veitforabetterworld/pegel-mesh/hardware/pegel-sender/verify/report/sweeps.md

# Schwellen und Verläufe (SPICE)

| Größe | Wert |
|---|---|
| Laden frei beim Erwärmen ab [°C] | 3.09 |
| Ladesperre beim Abkühlen ab [°C] | 0.978 |
| Heizung aus beim Erwärmen ab [°C] | 5.06 |
| Heizung an beim Abkühlen ab [°C] | 3.6 |
| Netzteil mit Steckbrücke: Laden ab [V] | 10.4 |
| Netzteil mit Steckbrücke: Laden bis [V] | 10.2 |
| Netzteil mit Steckbrücke: Ladestrom max. [A] | 2.36 |
| Netzteil ohne Steckbrücke: Laden ab [V] | — (keine Schaltung) |
| Netzteil ohne Steckbrücke: Laden bis [V] | — (keine Schaltung) |
| Netzteil ohne Steckbrücke: Ladestrom max. [A] | 0.0316 |
| Sonde 30 mA, Zelle 3.3 V: V12_PROBE Endwert [V] | 12.4 |
| Sonde 30 mA, Zelle 3.3 V: Anstieg auf 90 % [ms] | 1.43 |
| Sonde 30 mA, Zelle 3.3 V: Spitzenstrom Q5 [A] | 0.0301 |
| Sonde 30 mA, Zelle 3.3 V: Ugs Q5 min [V] | -6.22 |
| Sonde 30 mA, Zelle 2.9 V: V12_PROBE Endwert [V] | 12.4 |
| Sonde 30 mA, Zelle 2.9 V: Anstieg auf 90 % [ms] | 1.81 |
| Sonde 30 mA, Zelle 2.9 V: Spitzenstrom Q5 [A] | 0.0301 |
| Sonde 30 mA, Zelle 2.9 V: Ugs Q5 min [V] | -6.22 |

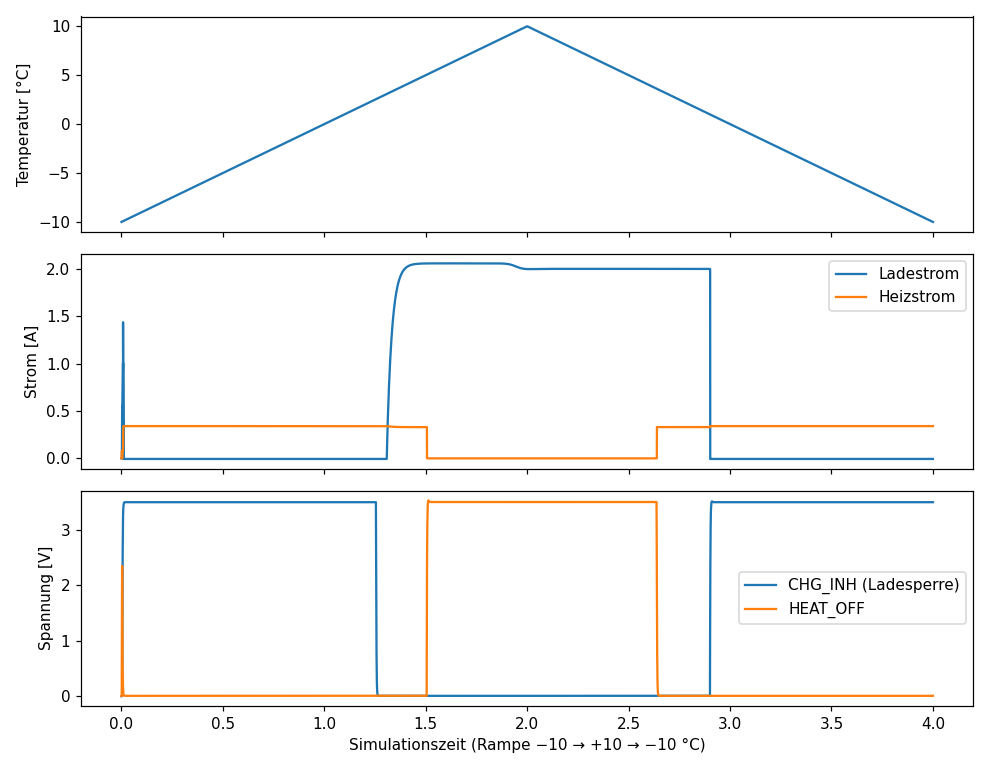
[picture p4: hardware/pegel-sender/verify/report/temperatur.png]
Temperatur


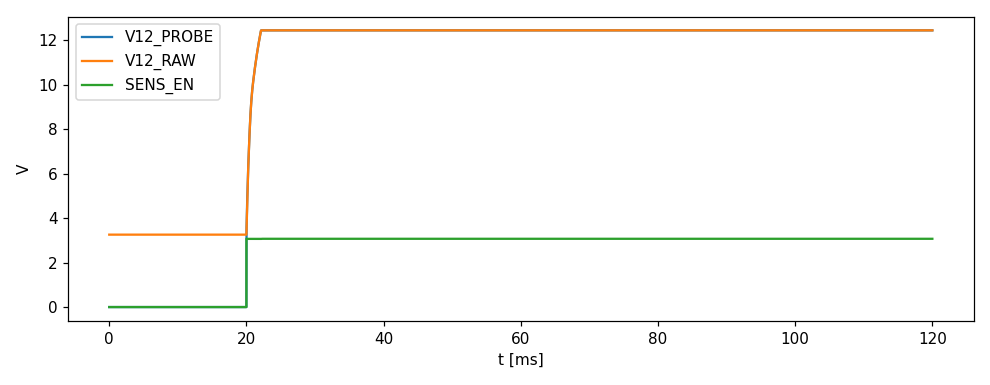
[picture p5: hardware/pegel-sender/verify/report/sonde_ein.png]
Sonde
