veitforabetterworld/pegel-mesh/hardware/pegel-sender/preview/pegel-sender-bottom.png

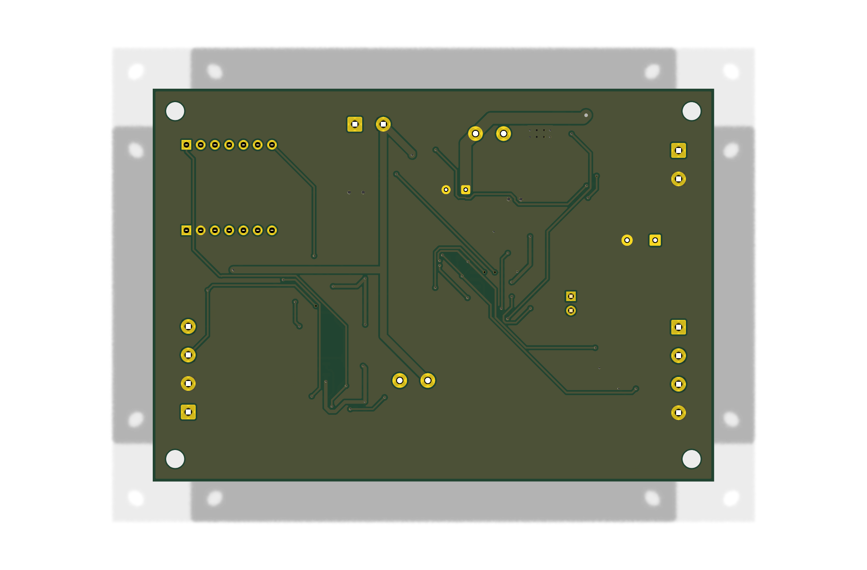
hardware/pegel-sender/preview/pegel-sender-bottom.png
