veitforabetterworld/pegel-mesh/hardware/pegel-sender/preview/pegel-sender-schematic-blocks.png

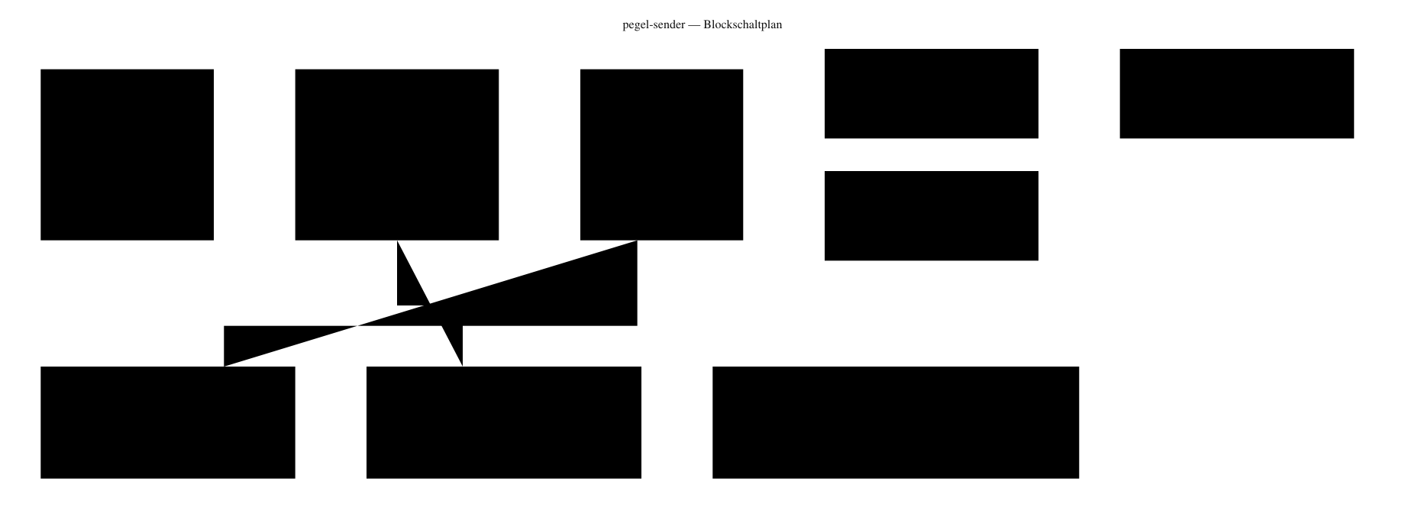
hardware/pegel-sender/preview/pegel-sender-schematic-blocks.png
