veitforabetterworld/pegel-mesh/hardware/pegel-sender/preview/schematic-12v.png

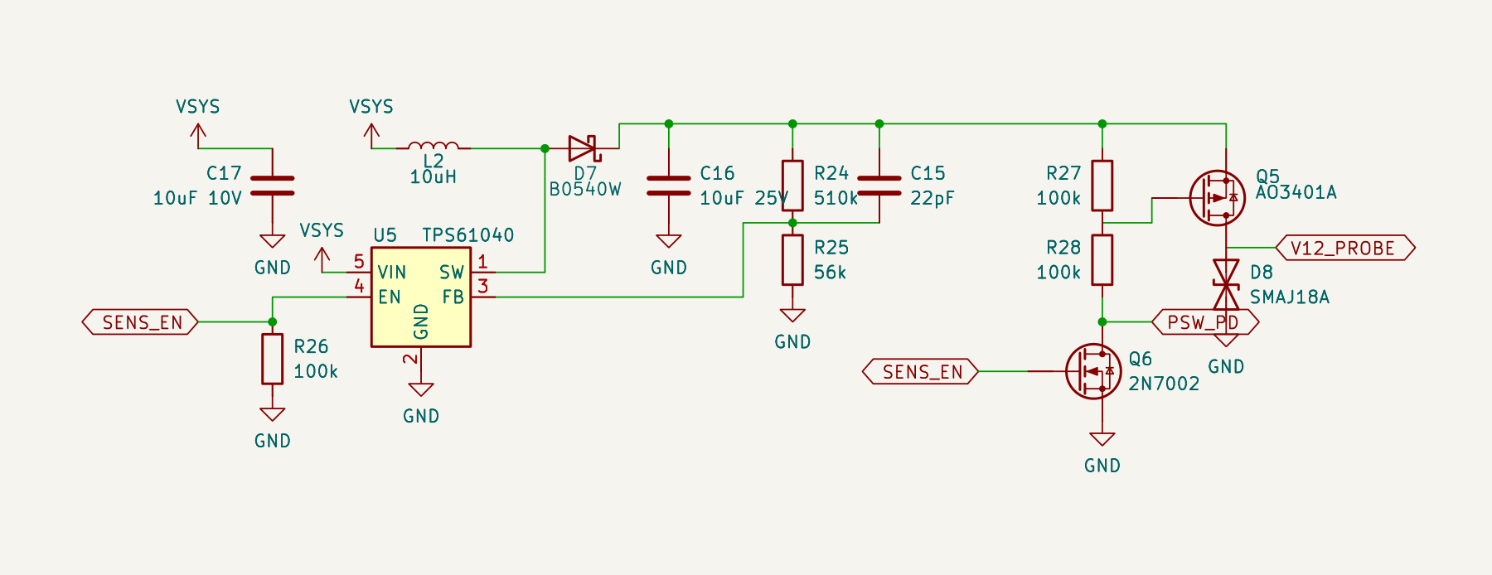
hardware/pegel-sender/preview/schematic-12v.png
