veitforabetterworld/pegel-mesh/hardware/pegel-sender/preview/schematic-battery.png

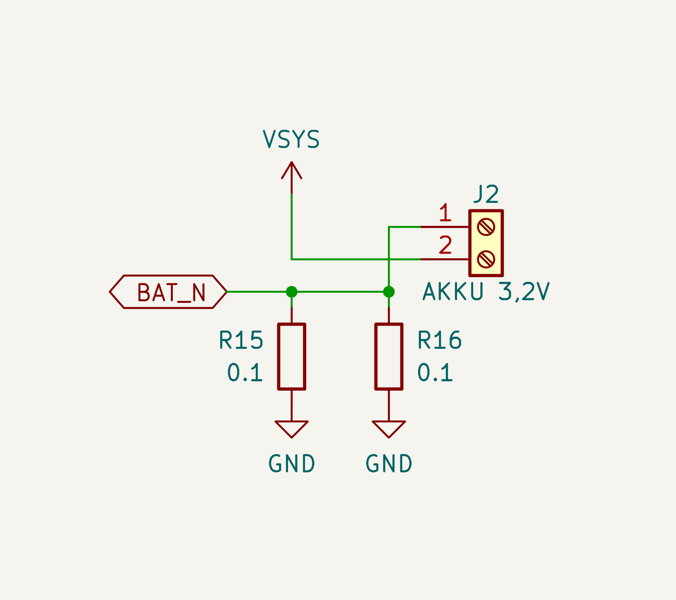
hardware/pegel-sender/preview/schematic-battery.png
