veitforabetterworld/pegel-mesh/hardware/pegel-sender/preview/schematic-charger.png

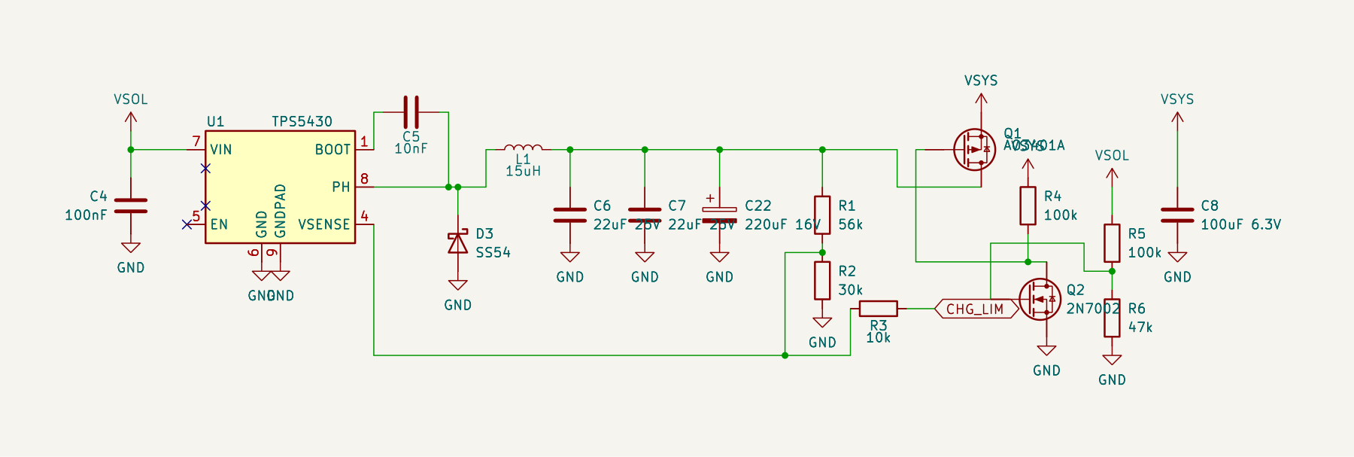
hardware/pegel-sender/preview/schematic-charger.png
