veitforabetterworld/pegel-mesh/hardware/pegel-sender/preview/schematic-frost.png

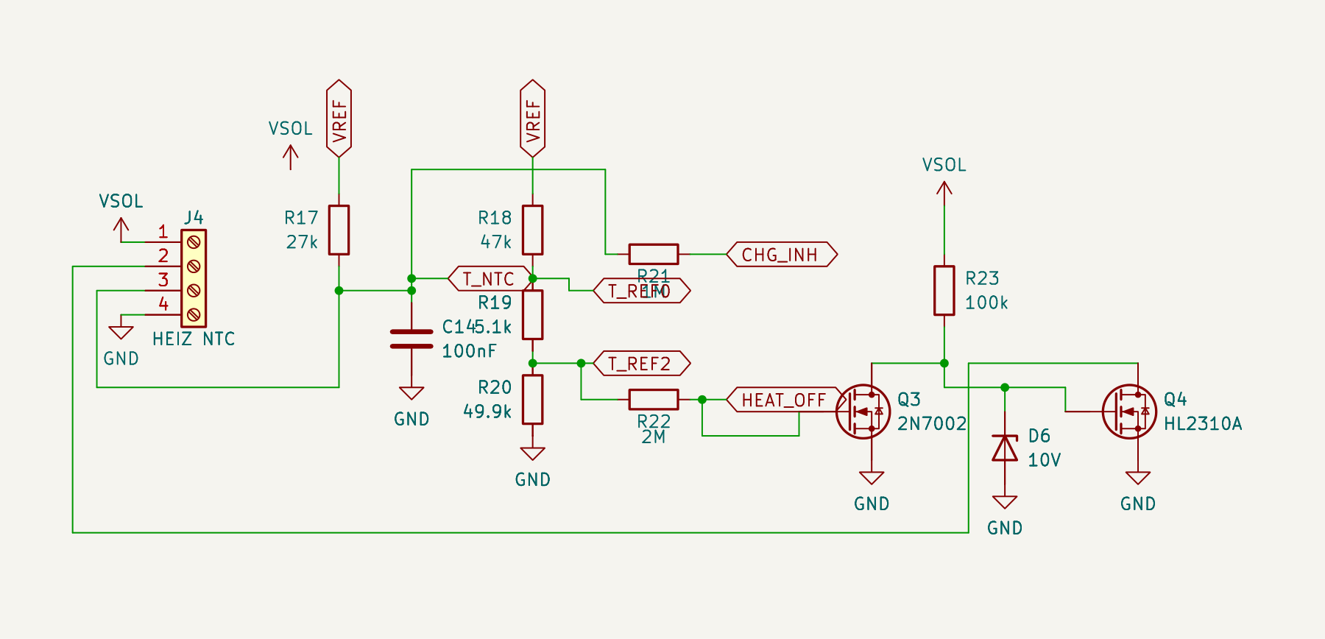
hardware/pegel-sender/preview/schematic-frost.png
