veitforabetterworld/pegel-mesh/hardware/pegel-sender/preview/schematic-mppt.png

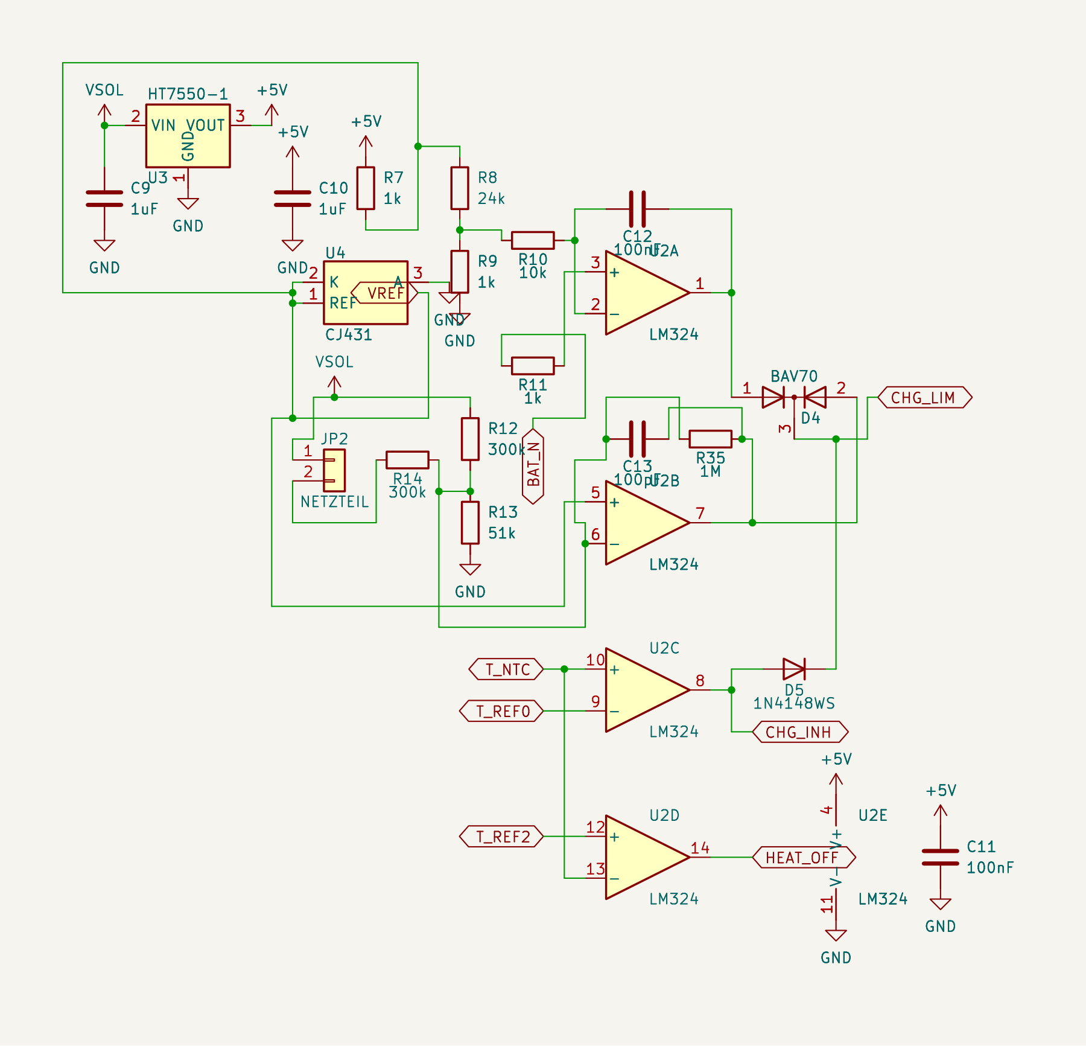
hardware/pegel-sender/preview/schematic-mppt.png
