veitforabetterworld/pegel-mesh/hardware/pegel-sender/preview/schematic-rs485.png

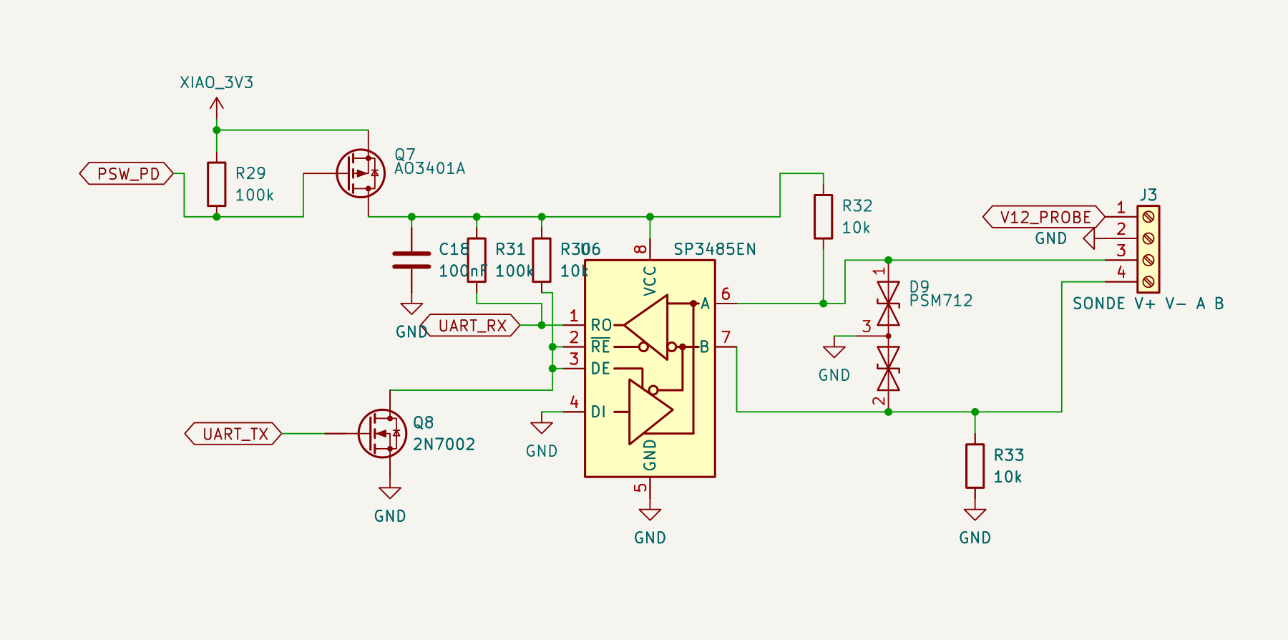
hardware/pegel-sender/preview/schematic-rs485.png
