veitforabetterworld/pegel-mesh/hardware/pegel-sender/preview/schematic-solar.png

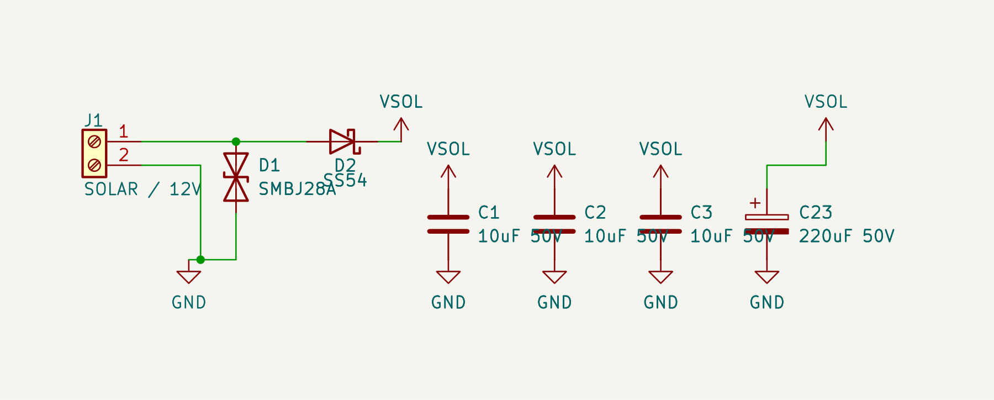
hardware/pegel-sender/preview/schematic-solar.png
