veitforabetterworld/pegel-mesh/hardware/pegel-sender/preview/schematic-xiao.png

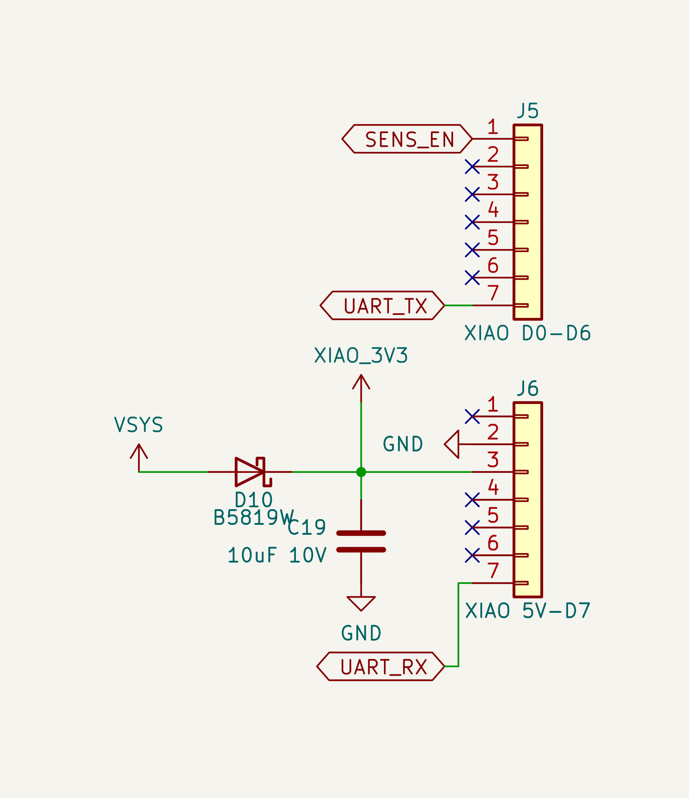
hardware/pegel-sender/preview/schematic-xiao.png
