veitforabetterworld/pegel-mesh/hardware/pegel-sender/fab/pegel-sender-bom.csv

Comment | Designator | Footprint | LCSC Part #
SMBJ28A | D1 | D_SMB | C19077582
SS54 | D2,D3 | D_SMA | C22452
10uF 50V | C1,C2,C3 | C_1206_3216Metric | C13585
TPS5430 | U1 | TI_SO-PowerPAD-8_ThermalVias | C9864
100nF | C4,C11,C12,C14,C18 | C_0603_1608Metric | C14663
10nF | C5 | C_0603_1608Metric | C57112
22uF 25V | C6,C7 | C_0805_2012Metric | C45783
56k | R1,R25 | R_0603_1608Metric | C23206
30k | R2 | R_0603_1608Metric | C22984
10k | R3,R10,R30,R32,R33 | R_0603_1608Metric | C25804
AO3401A | Q1,Q5,Q7 | SOT-23 | C15127
100k | R4,R5,R23,R26,R27,R28,R29,R31 | R_0603_1608Metric | C25803
2N7002 | Q2,Q3,Q6,Q8 | SOT-23 | C8545
47k | R6,R18 | R_0603_1608Metric | C25819
100uF 6.3V | C8 | C_1206_3216Metric | C15008
HT7550-1 | U3 | SOT-89-3 | C16106
1uF | C9,C10 | C_0603_1608Metric | C15849
LM324 | U2 | SOIC-14_3.9x8.7mm_P1.27mm | C71035
CJ431 | U4 | SOT-23 | C3113
1k | R7,R9,R11 | R_0603_1608Metric | C21190
24k | R8 | R_0603_1608Metric | C23352
300k | R12,R14 | R_0603_1608Metric | C23024
51k | R13 | R_0603_1608Metric | C23196
1M | R35,R21 | R_0603_1608Metric | C22935
100pF | C13 | C_0603_1608Metric | C14858
BAV70 | D4 | SOT-23 | C68978
1N4148WS | D5 | D_SOD-323 | C2128
0.1 | R15,R16 | R_1206_3216Metric | C25334
27k | R17 | R_0603_1608Metric | C22967
5.1k | R19 | R_0603_1608Metric | C23186
49.9k | R20 | R_0603_1608Metric | C23184
2M | R22 | R_0603_1608Metric | C22976
10V | D6 | D_SOD-123 | C19077408
HL2310A | Q4 | SOT-23 | C7420347
TPS61040 | U5 | SOT-23-5 | C7722
B0540W | D7 | D_SOD-123 | C7420325
510k | R24 | R_0603_1608Metric | C23192
22pF | C15 | C_0603_1608Metric | C1653
10uF 25V | C16 | C_0805_2012Metric | C15850
10uF 10V | C17,C19 | C_0603_1608Metric | C19702
SMAJ18A | D8 | D_SMA | C19077538
SP3485EN | U6 | SOIC-8_3.9x4.9mm_P1.27mm | C8963
PSM712 | D9 | SOT-23 | C32677
B5819W | D10 | D_SOD-123 | C64885
