veitforabetterworld/pegel-mesh/hardware/pegel-sender/pegel-sender.kicad_pcb

## KiCad design hardware/pegel-sender/pegel-sender.kicad_pcb (2026-10-31)

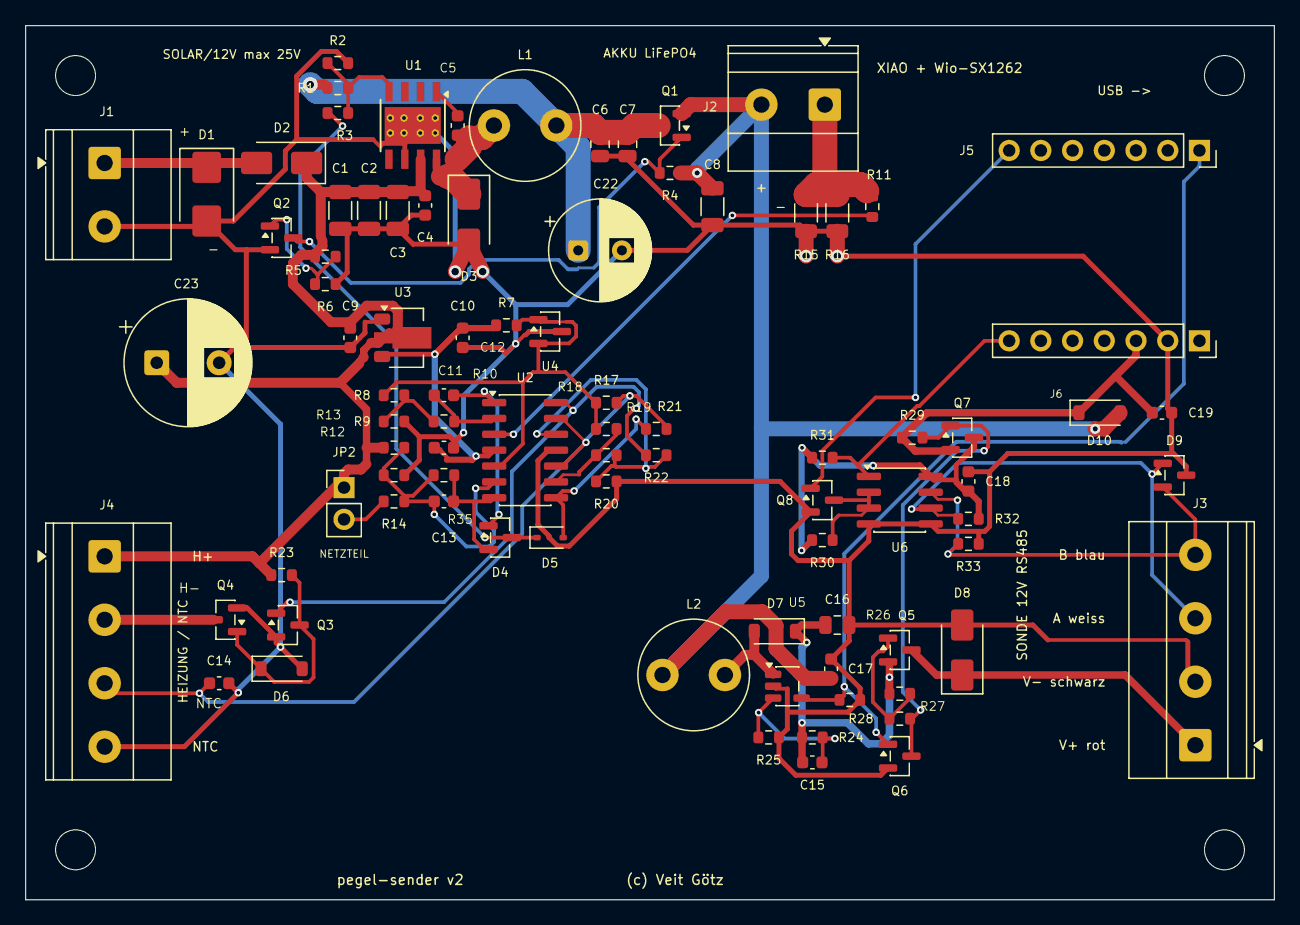
[picture p16: board pegel-sender.kicad_pcb from above]

Board: 2 copper layers, 100.0 x 70.0 mm, 92 parts (0 on the bottom side), 42 nets.

Parts:
C1, C2, C3: 10uF 50V; C_1206_3216Metric
C4, C11, C12, C14, C18: 100nF; C_0603_1608Metric
C5: 10nF; C_0603_1608Metric
C6, C7: 22uF 25V; C_0805_2012Metric
C8: 100uF 6.3V; C_1206_3216Metric
C9, C10: 1uF; C_0603_1608Metric
C13: 100pF; C_0603_1608Metric
C15: 22pF; C_0603_1608Metric
C16: 10uF 25V; C_0805_2012Metric
C17, C19: 10uF 10V; C_0603_1608Metric
C22: 220uF 16V; CP_Radial_D8.0mm_P3.50mm
C23: 220uF 50V; CP_Radial_D10.0mm_P5.00mm
D1: SMBJ28A; D_SMB
D2, D3: SS54; D_SMA
D4: BAV70; SOT-23
D5: 1N4148WS; D_SOD-323
D6: 10V; D_SOD-123
D7: B0540W; D_SOD-123
D8: SMAJ18A; D_SMA
D9: PSM712; SOT-23
D10: B5819W; D_SOD-123
H1, H2, H3, H4: M3; MountingHole_3.2mm_M3
J1: SOLAR / 12V; TerminalBlock_Phoenix_MKDS-1,5-2-5.08_1x02_P5.08mm_Horizont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
J2: AKKU 3,2V; TerminalBlock_Phoenix_MKDS-1,5-2-5.08_1x02_P5.08mm_Horizont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
J3: SONDE V+ V- A B; TerminalBlock_Phoenix_MKDS-1,5-4-5.08_1x04_P5.08mm_Horizont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
J4: HEIZ NTC; TerminalBlock_Phoenix_MKDS-1,5-4-5.08_1x04_P5.08mm_Horizont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
J5: XIAO D0-D6; PinSocket_1x07_P2.54mm_Vertical
J6: XIAO 5V-D7; PinSocket_1x07_P2.54mm_Vertical
JP2: NETZTEIL; PinHeader_1x02_P2.54mm_Vertical
L1: 15uH; L_Radial_D8.7mm_P5.00mm_Fastron_07HCP
L2: 10uH; L_Radial_D8.7mm_P5.00mm_Fastron_07HCP
Q1, Q5, Q7: AO3401A; SOT-23
Q2, Q3, Q6, Q8: 2N7002; SOT-23
Q4: HL2310A; SOT-23
R1, R25: 56k; R_0603_1608Metric
R2: 30k; R_0603_1608Metric
R3, R10, R30, R32, R33: 10k; R_0603_1608Metric
R4, R5, R23, R26, R27, R28, R29, R31: 100k; R_0603_1608Metric
R6, R18: 47k; R_0603_1608Metric
R7, R9, R11: 1k; R_0603_1608Metric
R8: 24k; R_0603_1608Metric
R12, R14: 300k; R_0603_1608Metric
R13: 51k; R_0603_1608Metric
R15, R16: 0.1; R_1206_3216Metric
R17: 27k; R_0603_1608Metric
R19: 5.1k; R_0603_1608Metric
R20: 49.9k; R_0603_1608Metric
R21, R35: 1M; R_0603_1608Metric
R22: 2M; R_0603_1608Metric
R24: 510k; R_0603_1608Metric
U1: TPS5430; TI_SO-PowerPAD-8_ThermalVias
U2: LM324; SOIC-14_3.9x8.7mm_P1.27mm
U3: HT7550-1; SOT-89-3
U4: CJ431; SOT-23
U5: TPS61040; SOT-23-5
U6: SP3485EN; SOIC-8_3.9x4.9mm_P1.27mm

Connections:
+5V: C10.1, C11.1, R7.1, U2.4, U3.3
BAT_N: J2.1, R11.1, R15.1, R16.1
BST_FB: C15.2, R24.2, R25.1, U5.3
BST_SW: D7.2, L2.2, U5.1
CC_INT: C12.1, R10.2, U2.2
CC_OUT: C12.2, D4.1, U2.1
CC_SENSE: R11.2, U2.3
CC_SET: R8.2, R9.1, R10.1
CHG_BOOT: C5.1, U1.1
CHG_FB: R1.2, R2.1, R3.2, U1.4
CHG_INH: D5.2, R21.1, U2.8
CHG_LIM: D4.3, D5.1, R3.1
CHG_OUT: C6.1, C7.1, C22.1, L1.2, Q1.3, R1.1
CHG_PG: Q1.1, Q2.3, R4.1
CHG_PGD: Q2.1, R5.2, R6.1
CHG_SW: C5.2, D3.1, L1.1, U1.8
GND: C1.2, C2.2, C3.2, C4.2, C6.2, C7.2, C8.2, C9.2, C10.2, C11.2, C14.2, C16.2, C17.2, C18.2, C19.2, C22.2, C23.2, D1.2, D3.2, D6.2, D8.2, D9.3, J1.2, J3.2, J4.4, J6.2, Q2.2, Q3.2, Q4.2, Q6.2, Q8.2, R2.2, R6.2, R9.2, R13.2, R15.2, R16.2, R20.2, R25.2, R26.2, R33.2, U1.6, U1.9, U2.11, U3.1, U4.3, U5.2, U6.4, U6.5
HEAT_G: D6.1, Q3.3, Q4.1, R23.2
HEAT_N: J4.2, Q4.3
HEAT_OFF: Q3.1, R22.1, U2.14
IN_RAW: D1.1, D2.2, J1.1
PSW_G: Q5.1, R27.2, R28.1
PSW_PD: Q6.3, Q7.1, R28.2, R29.2
RS485_A: D9.1, J3.3, R32.1, U6.6
RS485_B: D9.2, J3.4, R33.1, U6.7
RS_DE: Q8.3, R30.2, U6.2, U6.3
RS_VCC: C18.1, Q7.3, R30.1, R31.1, R32.2, U6.8
SENS_EN: J5.1, Q6.1, R26.1, U5.4
T_NTC: C14.1, J4.3, R17.2, R21.2, U2.10, U2.13
T_REF0: R18.2, R19.1, U2.9
T_REF2: R19.2, R20.1, R22.2, U2.12
UART_RX: J6.7, R31.2, U6.1
UART_TX: J5.7, Q8.1
V12_PROBE: D8.1, J3.1, Q5.3
V12_RAW: C15.1, C16.1, D7.1, Q5.2, R24.1, R27.1
VIN_DIV: C13.1, R12.2, R13.1, R14.2, R35.1, U2.6
VIN_J: JP2.2, R14.1
VIN_OUT: C13.2, D4.2, R35.2, U2.7
VREF: R7.2, R8.1, R17.1, R18.1, U2.5, U4.1, U4.2
VSOL: C1.1, C2.1, C3.1, C4.1, C9.1, C23.1, D2.1, J4.1, JP2.1, R5.1, R12.1, R23.1, U1.7, U3.2
VSYS: C8.1, C17.1, D10.2, J2.2, L2.1, Q1.2, R4.2, U5.5
XIAO_3V3: C19.1, D10.1, J6.3, Q7.2, R29.1
