veitforabetterworld/pegel-mesh/(commit log)

2026-10-29 feat: Pegel-Sender und -Empfänger auf MeshCore mit 13-Byte-HMAC-Paket
2026-10-29 fix(sender): Log blockiert den Sendetakt nicht mehr; Statuszeilen
    [main.cpp]
2026-10-29 feat(sender): Pegelsonde über RS485/Modbus RTU (D6 TX, D7 RX, D0 DE/RE)
    Liest wie water-level-sensor.ino Register 4 (Funktion 3, Adresse 0x01,
    9600 8N1) in cm; ohne gültigen Wert wird nichts gesendet. PEGEL_SENSOR=0
    schaltet auf Dummywerte zurück.
2026-10-29 feat: Fehlercodes der Pegelsonde über Funk und API (status)
    Sender: Lesefehler gehen als level_mm = 0xFF00 + Code statt eines Messwerts
    raus (1 keine Antwort, 2 außerhalb des Messbereichs). Empfänger: schickt sie
    als status an POST /v1/stations/{id}/observations.
2026-10-30 hardware: generated carrier board (placement, nets, fab export)
    [pegel-sender.kicad_pcb]
2026-10-30 hardware: route carrier board with Freerouting, GND stitching, fab data
    [pegel-sender-B_Cu.gbl, pegel-sender-B_Mask.gbs, pegel-sender-B_Paste.gbp, pegel-sender-B_Silkscreen.gbo, pegel-sender-Edge_Cuts.gm1, pegel-sender-F_Cu.gtl, pegel-sender-F_Mask.gts, pegel-sender-F_Paste.gtp]
2026-10-30 Board silkscreen labels, sender firmware for the carrier board
    - Connector pin labels (solar/battery +/-, probe wire colors), jumper values on silkscreen
    - SC16IS740 I2C UART driver with automatic RS485 direction, INA226 battery readout
    - Probe supply on D0 switched on ahead of each measurement (PEGEL_SENSOR_WARMUP_MS)
    - PEGEL_BOARD selects carrier board (default) or the RS485-module breadboard setup
    [pegel-sender-B_Cu.gbl, pegel-sender-B_Mask.gbs, pegel-sender-B_Paste.gbp, pegel-sender-B_Silkscreen.gbo, pegel-sender-Edge_Cuts.gm1, pegel-sender-F_Cu.gtl, pegel-sender-F_Mask.gts, pegel-sender-F_Paste.gtp]
2026-10-30 hardware: publish wired schematics and fab
    Block PNGs stay in git so the README renders. Ignore ERC
    reports, accidental plots, and KiCad backups. Drop stale
    fab board previews. Sender skips the probe when the pack
    is low.
    [L_Bourns_SRP1245A.step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]
2026-10-30 hardware: fix frost lockout, Q4 gate overvoltage, MPPT threshold reference
    - Frost lockout pulls the CN3795 MPPT pin again instead of the protection's charge FET:
    with that FET off, its body diode sits in the discharge path and ~0.6 V across the
    FETs trips the HY2112 discharge overcurrent (100-200 mV), disconnecting the battery
    - Hysteresis from the comparator output to T_NTC (4.7M, ~1 K)
    - Q4 (AO3401A, Vgs max 12 V) saw -12.3 V; R53 divides to -6.2 V
    - MPPT/12 V-supply threshold referenced to +3V3 instead of VSYS (was 11.2 V at a
    2.8 V battery, so a 12 V supply could not charge an empty battery); 976k/1M
    - SMAJ15A on the probe supply line, CHRG LED resistor 10k (0.11 W at 25 V in 0805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
    [pegel-sender-B_Cu.gbl, pegel-sender-B_Mask.gbs, pegel-sender-B_Paste.gbp, pegel-sender-B_Silkscreen.gbo, pegel-sender-Edge_Cuts.gm1, pegel-sender-F_Cu.gtl, pegel-sender-F_Mask.gts, pegel-sender-F_Paste.gtp]
2026-10-30 hardware: schematic PNGs on Windows, fix RS485 sheet layout conflicts
    - svg_png.py: rsvg-convert, otherwise PyMuPDF (Windows)
    - Single-unit ICs are turned 0/180 deg so their pins face already placed partners;
    U6 had its XTAL pins away from Y1, the crystal wires enclosed the SDA stub
    (Label I2C_SDA missing, open end)
    - Nets without a label get a second pass with their labels placed first
    - C6, C7, D4, R7 belong to the charger sheet, not MPPT
    - All sheets regenerated: 0 conflicts
2026-10-30 hardware: new schematic generator with label-based layout
    Replaces schematic_wired.py (maze-routed wires across the sheet, nudged texts).
    - ICs, connectors and transistors in a row on top, ordered from the connectors
    - Every pin: short stub with a net label or supply/GND symbol; adjacent pins on the
    same net share one
    - Two-terminal parts upright in a grid below, grouped by the IC they belong to;
    dividers as stacks with the tap labelled, parallel parts (heater bank,
    bulk caps) side by side on common rails
    - Supply symbols point up, GND down; global labels only for nets leaving the sheet
    - Field angle/justification compensated for symbol rotation
    - Each sheet is checked against design.p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
2026-10-30 hardware: wired schematics with per-sheet layout and orthogonal router
    - schematic_layout.py: part positions per sheet (signal flow left to right,
    supplies up, ground down), rails, supply symbols, labels only for nets
    leaving the sheet
    - schematic.py: A* router on a 1.27 mm grid (prefers the 2.54 mm grid, few
    bends, no wires through bodies or text, straight perpendicular crossings
    only, T-junctions with dots); two-pin parts flipped automatically so supply
    is on top and ground at the bottom; field angle/justify compensated for
    rotation and mirroring; every sheet checked against design.py via netlist
    - Box symbols ordered so pins face their partners (CN3795, HY2112, FS8205A,
    TLV3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
    [pegel-sender-bom.csv]
2026-10-30 hardware: circuit simulation, component stress and trace check with fixes
    SPICE suite (verify/) built from design.py: 19 operating cases, sweeps,
    long-term run, IPC-2221 trace check; firmware host tests with emulated
    probe, SC16IS740 and INA226.
    Fixes found by it: D14 blocks battery backfeed into the heater, MPPT
    detection on DC_F with hysteresis, more input capacitance (C4 1210, C22),
    new frost thresholds, LM2735 boost for 200 mA probe peaks, battery-low
    hysteresis in firmware. Board: fixed 1.2 mm tracks L1-R1-R8, D3 and
    protection FET ground vias, B.Cu keepout under the FETs.
    [pegel-sender-B_Cu.gbl, pegel-sender-B_Mask.gbs, pegel-sender-B_Paste.gbp, pegel-sender-B_Silkscreen.gbo, pegel-sender-Edge_Cuts.gm1, pegel-sender-F_Cu.gtl, pegel-sender-F_Mask.gts, pegel-sender-F_Paste.gtp]
2026-10-31 hardware: larger D1, Q9 and D12; room for the J3 labels
    - D1 SMBJ26A -> SMBJ28A (90 % of Vwm at -25 °C open circuit, was 97 %;
    SMBJ30A would break down above the CN3795's 33 V)
    - Q9 AO3401A -> Si2319CDS (40 V, ±20 V): Uds 62 %, Ugs 50 %
    - D12 SMAJ15A -> SMAJ18A: 68 % at 12.3 V
    - J3: Q4, R15, R18, R19 and D12 moved; "SONDE 12V RS485" vertical
    beside the pin texts, which now sit next to their pins
    - B.Cu keepout under Q2/Q3 extended to the board edge so signal
    tracks cannot fence in the GND island
    - pcb_check.py evaluates zone fills on all of a zone's layers
    [pegel-sender-B_Cu.gbl, pegel-sender-B_Mask.gbs, pegel-sender-B_Paste.gbp, pegel-sender-B_Silkscreen.gbo, pegel-sender-Edge_Cuts.gm1, pegel-sender-F_Cu.gtl, pegel-sender-F_Mask.gts, pegel-sender-F_Paste.gtp]
2026-10-31 docs: panel and battery sizing for flat land and uplands
    Winter simulation over 18 winters of hourly PVGIS data with half-day shade,
    heater, frost lock and an aged LiFePO4 cell.
2026-10-31 hardware: cheapest JLCPCB build, basic/preferred parts only
    All 45 SMD part types are JLCPCB basic or preferred (no loading fee);
    inductors, terminals and XIAO sockets are through-hole for hand soldering.
    - Charger: TPS5430 buck at 3.50 V; LM324 limits current to 2 A (shunt in
    the battery minus), holds the panel near 17 V (proportional loop, the
    integrator oscillated in weak light) and handles frost lock and heater.
    Single input for solar or 12 V supply, header jumper NETZTEIL.
    - XIAO runs from the battery through a Schottky diode; no 3.3 V regulator,
    no INA226, no protection IC (firmware measures VDD, sleeps below 2.6 V).
    - RS485: SP3485 on Serial1 with automatic direction, powered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
    [L_Bourns_SRP1245A.step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]
2026-10-31 hardware: Gerbers relative to the board corner like the CPL
    JLCPCB placed the parts next to the board: the Gerbers used KiCad's page
    origin, the placement file the lower-left board corner.
    [pegel-sender-B_Cu.gbl, pegel-sender-B_Mask.gbs, pegel-sender-B_Paste.gbp, pegel-sender-B_Silkscreen.gbo, pegel-sender-Edge_Cuts.gm1, pegel-sender-F_Cu.gtl, pegel-sender-F_Mask.gts, pegel-sender-F_Paste.gtp]
2026-10-31 hardware: JLCPCB rotation corrections in the CPL export
    SOT-23 -90, SOT-89 180, SOIC and TI PowerPAD 270 (JLCKicadTools table),
    otherwise pin 1 lands on the wrong corner.
    [pegel-sender-B_Cu.gbl, pegel-sender-B_Mask.gbs, pegel-sender-B_Paste.gbp, pegel-sender-B_Silkscreen.gbo, pegel-sender-Edge_Cuts.gm1, pegel-sender-F_Cu.gtl, pegel-sender-F_Mask.gts, pegel-sender-F_Paste.gtp]
2026-10-31 hardware: CPL rotations checked in the JLCPCB viewer (SOT-23 +180, PowerPAD none)
    [pegel-sender-cpl.csv]
2026-10-31 hardware: B0540W (D7) rotated 180 deg for its JLC model
    [pegel-sender-cpl.csv]
2026-10-31 hardware: SOT-23-5 rotated -90 for JLC, drop the D7 override
    [pegel-sender-cpl.csv]
2026-10-31 hardware: stable charger without battery, quiet panel regulation in weak light
    The simulation now models the TPS5430 with its datasheet type-III
    compensation (and OVP) and the LM324 with slew rate. That showed ~10 deg
    phase margin of the charger loop without battery and the panel voltage
    swinging by +-2.8 V at 5-10 % light. C22 (220 uF with ESR at the charger
    output, as in TI's reference design) and C23 (220 uF at the panel) fix
    both; TI's all-ceramic network made the panel loop oscillate and is not
    used. R7 1k so the CJ431 always gets its 1 mA. Tracks keep 0.5 mm from
    the board edge.
    [pegel-sender-B_Cu.gbl, pegel-sender-B_Mask.gbs, pegel-sender-B_Paste.gbp, pegel-sender-B_Silkscreen.gbo, pegel-sender-Edge_Cuts.gm1, pegel-sender-F_Cu.gtl, pegel-sender-F_Mask.gts, pegel-sender-F_Paste.gtp]
2026-10-31 README: short, only board, parts, connections and installation
2026-11-09 GPS-Tracker: Firmware für XIAO nRF54LM20A Sense, Empfänger als Gateway zu tracker.plenivo.de
    - firmware/tracker: Sitzungen mit GPS (L76K), Akku über nPM1300, Bewegungsalarm über den LSM6DS3TR-C
    (Wake-up auf INT1, weckt auch aus System OFF), Schlaf in System OFF mit Zustand in .noinit-RAM.
    Meldungen werden zwischengespeichert (1024 Einträge) und mit Zeitstempel (GRTC) nachgereicht,
    bis zu 7 je verschlüsselter MeshCore-REQ, neueste zuerst; die Antwort quittiert und bringt die
    Einstellungen (Intervall, Alarmstufe, Alarmintervall).
    - Funk-SPI auf SPIM22 (tracker_target.cpp): SPIM21 teilt sich die Hardware mit UARTE21 (GNSS).
    - firmware/common/tracker_packet.h: Paketformat Uplink/Do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
